OntarioTechRacing/demo-repository/demo-repository.kicad_pcb

## KiCad design demo-repository.kicad_pcb (2024-07-11)

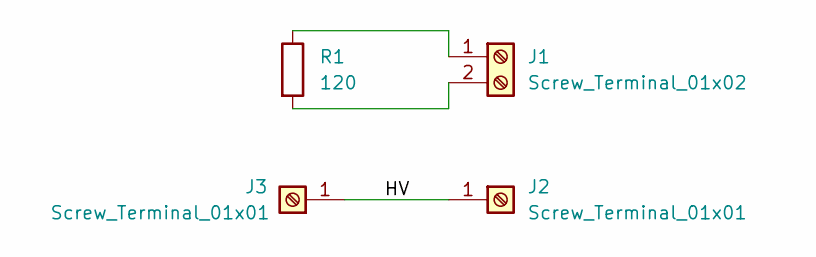
[picture p1: schematic demo-repository.kicad_sch, Template]

Parts:
J1: Screw_Terminal_01x02; PinHeader_1x02_P2.54mm_Vertical
J2, J3: Screw_Terminal_01x01; PinHeader_1x01_P2.54mm_Vertical
R1: 120; R_0603_1608Metric

Connections:
/HV: J2.1, J3.1
unnamed: J1.1, R1.1
unnamed: J1.2, R1.2

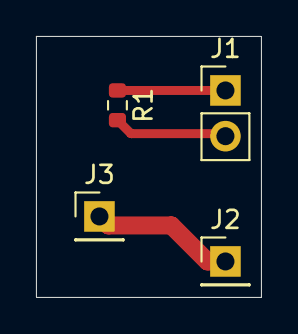
[picture p2: board demo-repository.kicad_pcb from above]

Board: 4 copper layers, 12.5 x 14.5 mm, 4 parts (0 on the bottom side), 3 nets.
