OntarioTechRacing/demo-repository/(threads)

Thread 14 (2024-07-06):

[Remove] <title>

danielljeon, 2024-07-06:
### Is there an existing issue or pull request for this?

- [X] I have searched the existing issues and pull requests

### Component requiring removal

DJ DJCOMP

### Impacted library types

Symbol, Footprint, Model (3D)

### Issue body

Body text `markdown`

### Has this component been flagged by any other open issues or pull requests?

No, there are no other references currently open

### Does this component impact any active production releases?

No, there are no active impacts

Closed 2024-07-06.

Thread 15 (2024-07-06):

[Request] <title>

danielljeon, 2024-07-06:
### Is there an existing issue or pull request for this?

- [X] I have searched the existing issues and pull requests

### New component being requested

DJ COMP

### Impacted library types

Symbol, Footprint, Model (3D)

### Issue body

asd

### Has this component completed a viability review?

Yes, it was approved as noted in the issue body

Closed 2025-03-06.
