OntarioTechRacing/demo-repository/(commit log)

2024-07-08 Add example KiCad project
    [Digistump ATtiny.kicad_pcb, Digistump ATtiny.kicad_sch, Digistump ATtiny_auto router test.kicad_pcb]
2024-07-08 Update to KiCad 8
    [Digistump ATtiny.kicad_sch]
2024-07-08 Update workflow and proj files
    [pcb.kicad_pcb, schematic.kicad_sch]
2024-07-08 Fix schematic and pcb paths
2024-07-08 Update for KiCad 8 schematic file extensions
2024-07-09 Remove old project
    [Digistump ATtiny_auto router test.kicad_pcb, pcb.kicad_pcb, schematic.kicad_sch]
2024-07-09 Add new KiCad project
    [kicad_template.kicad_pcb, kicad_template.kicad_sch]
2024-07-09 Adjust for KiBot
    [pcb.kicad_pcb, schematic.kicad_sch]
2024-07-11 Update workflow for repo name structure
    [demo-repository.kicad_pcb, demo-repository.kicad_sch]
2024-07-11 Remove specified PCB and schematic files
2024-07-11 Test for custom DRC checker rules
    [demo-repository.kicad_pcb, demo-repository.kicad_sch]
2024-07-11 Comment out filters and update preflight syntax
